wurthless-elektroniks/RGH1.3/patches/README

All patches generated by Modern Loadfare

These are to be applied on top of the normal xeBuild or XeLL patches.

- cbb_XXXX_nosmcsum all disable SMC checksum verification
- cbb_XXXX_post67, cbb_XXXX_ipc install POST 6/7 toggler and SMC IPC patches for 2-wire and 1/0-wire installs respectively
- cbb_XXXX_fast5050, cbb_XXXX_veryfast5050 install fast/very fast SDRAM training loops
