wurthless-elektroniks/RGH1.3/ppc/readme.md

# PowerPC assembly stubs

Woohoo!!!!! Dumb dogshit!!!

## To assemble

`ppc-linux-as -mcell -a64 hwinit_postcount_unified.s`

## Then what?

Get hexdump and paste it into cbbpatch.py.
