wurthless-elektroniks/RGH1.3/xebuild/README

Base xeBuild patches for CB_Bs that skip CB LDV check, stub out sanity checks in the fusecheck function, and skip the CD hashcheck.

- 4577, 5772, 6752 are all standard xeBuild patches
- 7378 is from elpiss
- All others are generated by Modern Loadfare with default settings (python3 loadfare.py --write-xebuild cbb_in.bin patch_out.bin)
