wurthless-elektroniks/RGH1.3/(threads)

Thread 2 (2025-09-05):

RGH3 loader breaks compatibility with older kernels

wurthless-elektroniks, 2025-09-05:
This issue affects RGH3 as well.

Behavior with Blades kernel: boot runs up until kernel init, but dies at POST 0x69 (INIT_KEY_VAULT, results in POST 0xFF and system halts).

Possible culprits include:
- Use of 9188 manufacturing CB_A (uses zeropaired key instead of getting CPU key from fuselines)
- RGH2to3 patches to CB_X v1 (RGH3 v2 on 15432's repo is a rewritten payload)

wurthless-elektroniks, 2025-09-06:
CB_X is not reading 0x20-0x40 of CB_B into registers r27/r28/r29/r30. CB_A reads those, but they are all zeroed in the CB_X header. If those are copied into 0x20-0x40 of CB_X, the system won't get past HWINIT.

Closed 2025-09-06.

Thread 3 (2025-09-06):

badjasper bootloops when system is warmed up

wurthless-elektroniks, 2025-09-06:
After system has been on for a while and power cycled, systems that need the badjasper workaround will continue flashing Red/Red on the ring of light. This can happen over 60 times in a row before the intended condition (boot fails at 0xDB) is met and the SMC power cycles the system.

Possible solution is to wait 5 to 10 cycles before power cycling.

Thread 4 (2025-09-06):

LED lightshow watchdog occasionally fails to reboot

wurthless-elektroniks, 2025-09-06:
Title says it all; there are times when the system gets through to kernel init but the kernel never starts (i.e., sends the LED bootanim). Most of the time, the LED lightshow catches this, but it occasionally doesn't reboot the system, and the system hangs with Red/Orange/Green LEDs on.

Unsure of cause.

Thread 5 (2025-09-06):

No RRoD / Christmas lights error handling

wurthless-elektroniks, 2025-09-06:
Two error cases need to be caught.

1. Red Ring of Death or other error raised by kernel: Code is there but isn't tested and not even hooked up.
2. Kernel can send LED statuses at boot including Christmas lights (Red/Red/Green/Green).

If the kernel raises an error we should immediately disarm all watchdogs so that the user can get the error codes etc.

Issue 2 can be replicated and tested easily by running Blades kernel without passing proper arguments to CB_B (i.e., use older buggy g3fix). Issue 1 means having to find a RRoD system in the parts bin or similar.

Thread 6 (2025-09-14):

Add support for alternative POST 7 pins

wurthless-elektroniks, 2025-09-14:
Disabling the tiltswitch might not be ideal for some people, so alternatives should be considered.

Best candidate is /EXT_PWR_ON_N which is only really used by kiosks and debug tools.

wurthless-elektroniks, 2025-09-30:
/EXT_PWR_ON_N support added, to be tested thoroughly later, but seems to work okay.

SMC_CPU_CHKSTOP_DETECT is the next candidate because the Falcon SMC doesn't do much with it. It only sets two flags (023h.3 and 029h.1) which are read later but it doesn't trigger a RRoD, reset, or anything else. However the line is pulled up by a 10k resistor (might not play as well with the diode) and either R3N8 or Q2P1 have to be removed to isolate the CPU checkstop line.

SMC_CPU_CHKSTOP_DETECT in Ghidra is `TR2` (0C8h.2).

Thread 9 (2025-09-20):

Trinity support for EXT+3

wurthless-elektroniks, 2025-09-20:
Trinity systems have a CPU_EXT_CLK_EN test point exposed, most likely next to the CPU_PLL_BYPASS point underneath the CPU as per the schematics. A port of EXT_CLK/EXT+3 to Trinity should be done so that there's an alternative to the other methods in case the PLL point is destroyed.

Stuff to do here:
- Find the CPU_EXT_CLK_EN test point and see how it works vs. phats
- Port SMC code to Trinity
- Make Trinity-specific xsvfs, if necessary

EXT_CLK is probably ineffective against Coronas because Coronas don't expose a standby clock signal (maybe there's a backup though). Even if it does work the success rate will be low. Also the removed POST signals on later Coronas and on Xbox 360 E boards make the SMC code completely useless.

Thread 10 (2025-09-24):

Better IO choice

Octal450, 2025-09-24:
Why on earth are using the tilt switch as an IO? You're using GPU reset done like RGH3 so why not just use the other one to GPIO0 so that you still have a working tilt switch?????

It doesn't make any sense.
