wurthless-elektroniks/RGH1.3/extplus3-192mhz-matrix-vhdl/divider_slow.vhd

library IEEE;
use IEEE.STD_LOGIC_1164.ALL;

-- divider

entity divider_slow is
	Port (
		CLK : in STD_LOGIC;
		CLK_S : out STD_LOGIC
	);
end divider_slow;

architecture arch of divider_slow is

constant div_value : integer := 2047;
signal counter : integer range 0 to div_value := 0;
signal new_clk : STD_LOGIC := '0';

begin

process (CLK, new_clk) is
begin
	if (rising_edge(CLK)) then -- divide further by processing only on rising edge
		if (counter < div_value) then
			counter <= counter + 1;
		else
			counter <= 0;
			new_clk <= not new_clk;
		end if;
	end if;
	
	CLK_S <= new_clk;
end process;

end arch;
