wurthless-elektroniks/RGH1.3/(commit log)

2025-08-21 another failed private repository?????
    [overall.sch]
2025-08-28 sizecoding/tweaks, add "hold powerbutton to power off" feature
2025-08-29 fixes and clarifications in vhdl
    [post_proc.vhd]
2025-09-02 more info about the bodge capacitor
2025-09-04 use jasper smc for falcon (workaround for falcon boards playing blind)
2025-09-09 better error handling in led lightshow watchdog
2025-09-25 checkpoint for much of EXT+3 xenon support
    [clk_doubler.sch, overall.sch]
2025-10-19 fix really dumb edge case
2025-10-20 add zero-wire method (very very early support)
2025-11-01 add raspberry pi pico support, finally
    so much for freerunner huh
2025-11-02 xenon 0wire: re-enable debug LED blinkies
2025-11-02 xenon 0wire: re-enable debug led statemachine
2025-12-13 restore powerup cause on rol watchdog timeout
2025-12-13 actually restore the powerup cause correctly...
2025-12-29 major timeout/error handling changes (things might break)
    it turns out that the normal infinite reboot method used by
    all hacked SMCs hides legitimate RRoDs and keeps rebooting.
    these changes now distinguish between when a timeout happens
    (and we should keep rebooting), and when a real error case
    happens.
    i'm a little lazy and not in the mood to dig my test consoles out
    of the bin, so any bugs that pop up should be reported...
2026-01-06 fix typo that broke soft reset powerup cause restore
2026-01-09 xenon 2wire/1wire: try pulling up I/Os so resistor isn't needed
    this is untested, complain to me if it doesn't work...
2026-01-10 remove powerupcause.py, it's unused and inaccurate
2026-01-25 couple important doc updates
